arwidcool/Scan-2000/2000 Omron/SCH_Keithley 2000 Omron SCAN V1.0_1-Main_2026-03-22.png

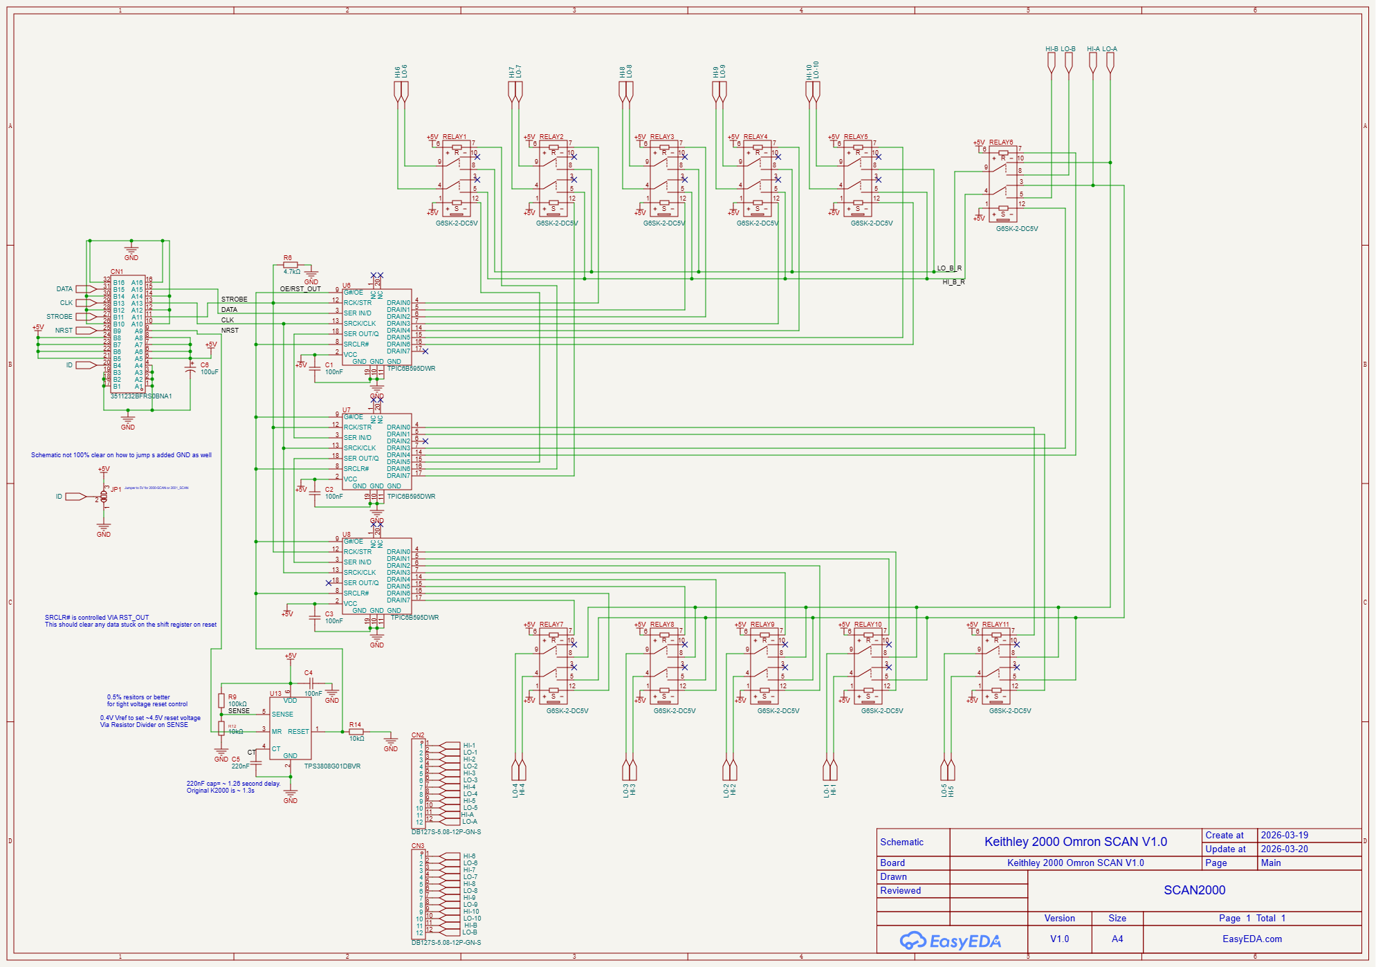
2000 Omron/SCH_Keithley 2000 Omron SCAN V1.0_1-Main_2026-03-22.png
