arwidcool/Scan-2000/2000 Panasonic DB25/SCH_Keithley 2000 SCAN Panasonic DB25 V1.0_1-Main_2026-03-22.png

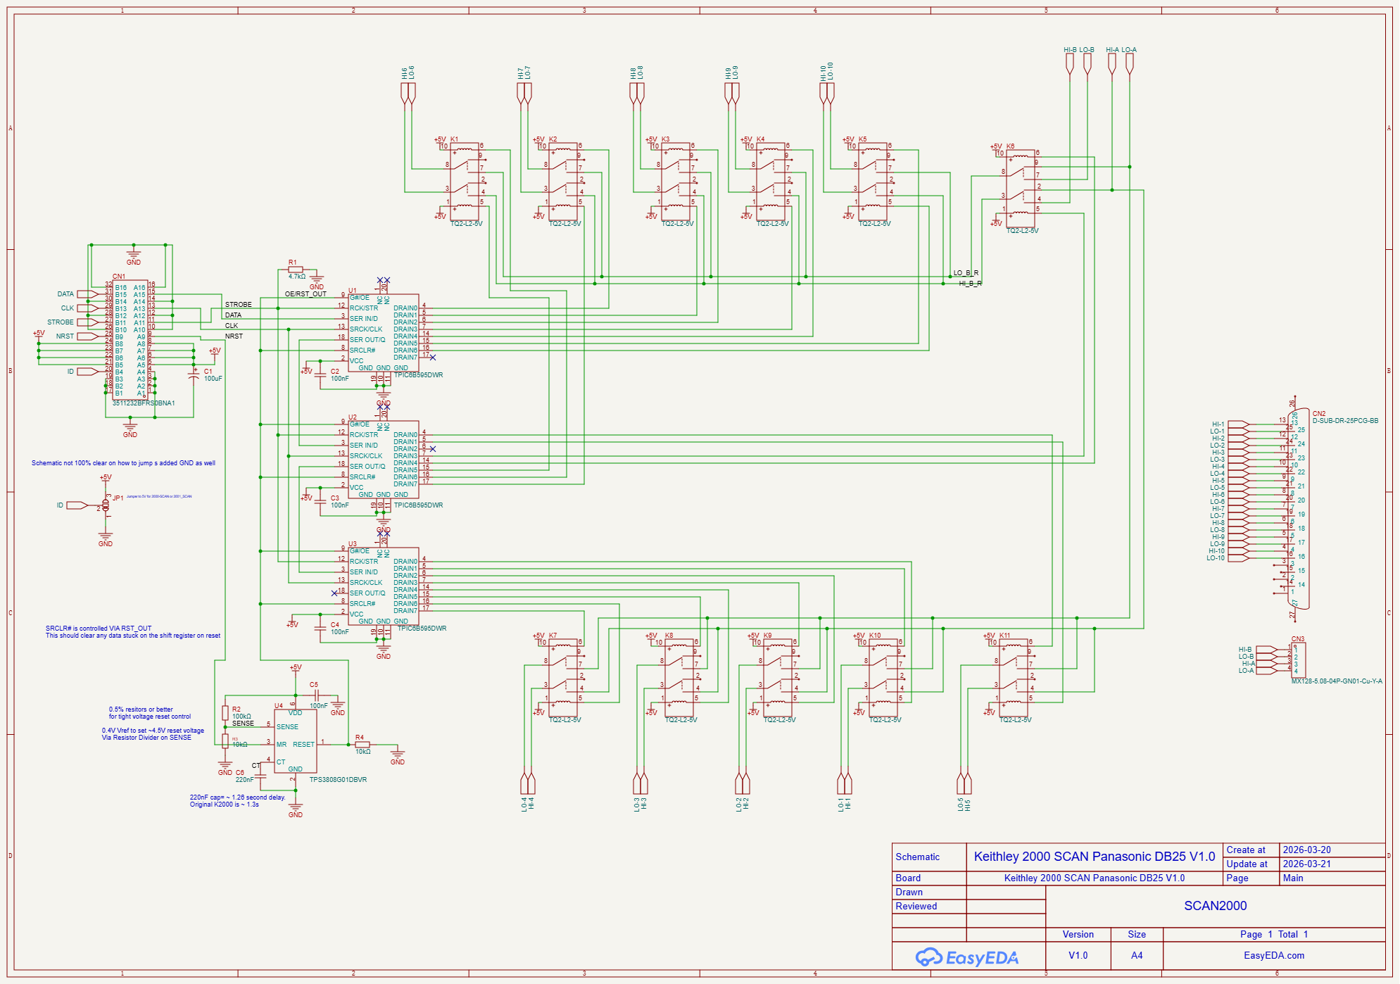
2000 Panasonic DB25/SCH_Keithley 2000 SCAN Panasonic DB25 V1.0_1-Main_2026-03-22.png
