arwidcool/Scan-2000/2001 Omron/SCH_Keithley 2001 Omron SCAN V1.0_1-Main_2026-03-22.png

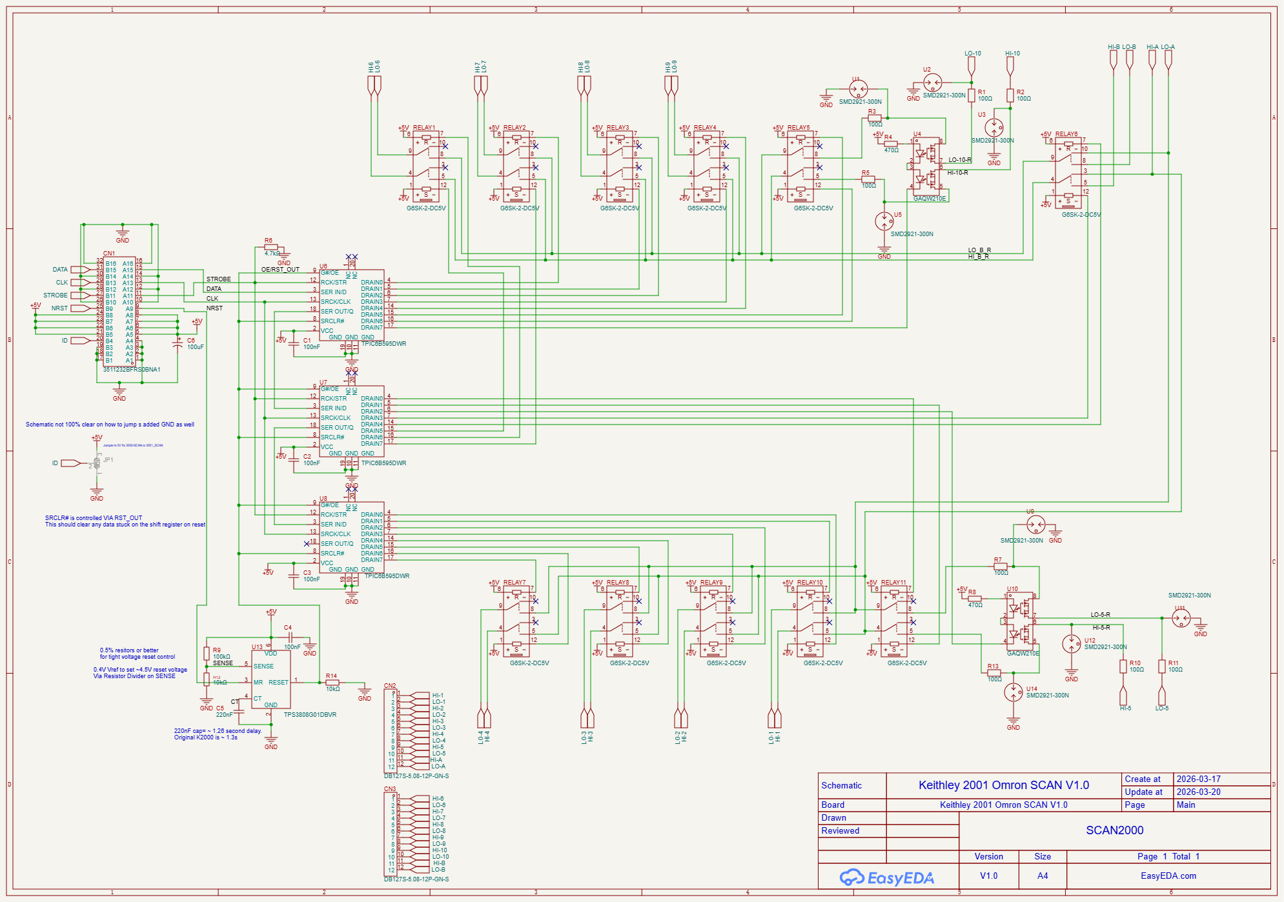
2001 Omron/SCH_Keithley 2001 Omron SCAN V1.0_1-Main_2026-03-22.png
