arwidcool/Scan-2000/2000 Panasonic DB25/BOM_Keithley 2000 SCAN Panasonic DB25 V1.0_Keithley 2000 SCAN Panasonic DB25 V1.0_2026-03-22.xlsx

No. | Quantity | Comment | Designator | Footprint | Value | Manufacturer Part | Manufacturer | Supplier Part | Supplier | LCSC Price | LCSC Stock | Primary Category | Secondary Category | JLCPCB Stock | JLCPCB Price
1 | 1 | 100uF | C1 | CAP-TH_BD8.0-P3.50-D0.6-FD | 100uF | ERJ1HM101F12OT | AISHI(艾华集团) | C106559 | LCSC |  |  | Capacitors | Aluminum Electrolytic Capacitors - Leaded | 12796 | 0.0079
2 | 4 | 100nF | C2,C3,C4,C5 | C0603 | 100nF | CL10B104KB8NNNC | SAMSUNG(三星) | C1591 | LCSC |  |  |  |  | 9229562 | 0.0005
3 | 1 | 220nF | C6 | C0603 | 220nF | CL10B224KA8NNNC | SAMSUNG(三星) | C21120 | LCSC |  |  |  |  | 2661535 | 0.0011
4 | 1 | 3511232BFRS0BNA1 | CN1 | CONN-TH_3511232BFRS0BNA1 |  | 3511232BFRS0BNA1 | JILN(锦凌) | C963692 | LCSC |  |  | Connectors | Board-to-Board and Backplane Connector | 1249 | 0.0912
5 | 1 | D-SUB-DR-25PCG-BB | CN2 | DB25-TH_D-SUB-DR-25PCG-BB |  | D-SUB-DR-25PCG-BB | XUNPU(讯普) | C19077345 | LCSC |  |  | Connectors | D-Sub / VGA Connectors | 695 | 0.1066
6 | 1 | MX128-5.08-04P-GN01-Cu-Y-A | CN3 | CONN-TH_4P-P5.08_MX128-5.08-04P-GN01-CU-Y-A |  | MX128-5.08-04P-GN01-Cu-Y-A | MAX(迈旭) | C5290377 | LCSC |  |  | Connectors | Screw Terminal Blocks | 357 | 0.0406
7 | 1 | Jumper_SolderJumper_3_Bridged12 | JP1 | Jumper:SolderJumper-3_P1.3mm_Bridged12_Pad1.0x1.5mm_NumberLabels | SolderJumper_3_Bridged12 |  |  |  |  | 0.8181
8 | 11 | TQ2-L2-5V | K1,K2,K3,K4,K5,K6,K7,K8,K9,K10,K11 | RELAY-TH_TQ2-L2-XXV |  | TQ2-L2-5V | PANASONIC(松下) | C1525303 | LCSC |  |  | Relays | Magnetic Latching Relays | 228 | 0.2171
9 | 1 | 4.7kΩ | R1 | R0603 | 4.7kΩ | RC0603FR-074K7L | YAGEO(国巨) | C99782 | LCSC |  |  |  |  | 3158032 | 0.0002
10 | 1 | 100kΩ | R2 | R0603 | 100kΩ | AR03DTCX1003 | Viking(光颉) | C319967 | LCSC |  |  | Resistors | Chip Resistor - Surface Mount | 30815 | 0.0019
11 | 1 | 10kΩ | R3 | R0603 | 10kΩ | 0603WAD1002T5E | UNI-ROYAL(厚声) | C167144 | LCSC |  |  | Resistors | Chip Resistor - Surface Mount | 96153 | 0.0009
12 | 1 | 10kΩ | R4 | R0603 | 10kΩ | RC0603FR-0710KL | YAGEO(国巨) | C98220 | LCSC |  |  |  |  | 9420368 | 0.0003
13 | 3 | TPIC6B595DWR | U1,U2,U3 | SOIC-20_L13.0-W7.6-P1.27-LS10.3-BL |  | TPIC6B595DWR | TI(德州仪器) | C7094 | LCSC |  |  | Logic | Shift Registers | 2574 | 0.168
14 | 1 | TPS3808G01DBVR | U4 | SOT-23-6_L2.9-W1.6-P0.95-LS2.8-BR |  | TPS3808G01DBVR | TI(德州仪器) | C19653 | LCSC |  |  | Power Management (PMIC) | Supervisor and Reset ICs | 12068 | 0.053
