arwidcool/Scan-2000/2000 Panasonic/BOM_Keithley 2000 SCAN Panasonic V1.0_Keithley 2000 SCAN Panasonic V1.0_2026-03-22.xlsx

No. | Quantity | Comment | Designator | Footprint | Value | Manufacturer Part | Manufacturer | Supplier Part | Supplier | LCSC Price | LCSC Stock | Primary Category | Secondary Category | JLCPCB Stock | JLCPCB Price
1 | 4 | 100nF | C2,C3,C4,C5 | C0603 | 100nF | CL10B104KB8NNNC | SAMSUNG(三星) | C1591 | LCSC |  |  |  |  | 9229562 | 0.0005
2 | 1 | 220nF | C6 | C0603 | 220nF | CL10B224KA8NNNC | SAMSUNG(三星) | C21120 | LCSC |  |  |  |  | 2661425 | 0.0011
3 | 4 | 22uF | C7,C8,C9,C10 | C0805 | 22uF | CL21A226MAYNNNE | SAMSUNG(三星) | C602037 | LCSC |  |  | Capacitors | Multilayer Ceramic Capacitors MLCC - SMD/SMT | 844649 | 0.005
4 | 1 | 3511232BFRS0BNA1 | CN1 | CONN-TH_3511232BFRS0BNA1 |  | 3511232BFRS0BNA1 | JILN(锦凌) | C963692 | LCSC |  |  | Connectors | Board-to-Board and Backplane Connector | 1249 | 0.0912
5 | 2 | DB127S-5.08-12P-GN-S | CN2,CN3 | CONN-TH_12P-P5.08_DB127S-5.08-12P-GN-S |  | DB127S-5.08-12P-GN-S | DORABO(地博电气) | C18198311 | LCSC |  |  | Connectors | Screw Terminal Blocks | 54 | 0.234
6 | 11 | TQ2-L2-5V | K1,K2,K3,K4,K5,K6,K7,K8,K9,K10,K11 | RELAY-TH_TQ2-L2-XXV |  | TQ2-L2-5V | PANASONIC(松下) | C1525303 | LCSC |  |  | Relays | Magnetic Latching Relays | 228 | 0.2171
7 | 1 | 4.7kΩ | R1 | R0603 | 4.7kΩ | RC0603FR-074K7L | YAGEO(国巨) | C99782 | LCSC |  |  |  |  | 3158032 | 0.0002
8 | 1 | 100kΩ | R2 | R0603 | 100kΩ | AR03DTCX1003 | Viking(光颉) | C319967 | LCSC |  |  | Resistors | Chip Resistor - Surface Mount | 30815 | 0.0019
9 | 1 | 10kΩ | R3 | R0603 | 10kΩ | 0603WAD1002T5E | UNI-ROYAL(厚声) | C167144 | LCSC |  |  | Resistors | Chip Resistor - Surface Mount | 96153 | 0.0009
10 | 1 | 10kΩ | R4 | R0603 | 10kΩ | RC0603FR-0710KL | YAGEO(国巨) | C98220 | LCSC |  |  |  |  | 9420368 | 0.0003
11 | 1 | 390mΩ | R5 | R1206 | 390mΩ | FRL1206FR390TS | FOJAN(富捷) | C2907353 | LCSC |  |  | Resistors | Chip Resistor - Surface Mount | 99036 | 0.0009
12 | 3 | TPIC6B595DWR | U1,U2,U3 | SOIC-20_L13.0-W7.6-P1.27-LS10.3-BL |  | TPIC6B595DWR | TI(德州仪器) | C7094 | LCSC |  |  | Logic | Shift Registers | 2574 | 0.168
13 | 1 | TPS3808G01DBVR | U4 | SOT-23-6_L2.9-W1.6-P0.95-LS2.8-BR |  | TPS3808G01DBVR | TI(德州仪器) | C19653 | LCSC |  |  | Power Management (PMIC) | Supervisor and Reset ICs | 12068 | 0.053
14 | 1 | Solder Jumper New | U5 | Solder Jumper New |  |  |  |  |  | 0.4675 |  | Utilities
