arwidcool/Scan-2000/2001 Omron/BOM_Keithley 2001 Omron SCAN V1.0_Keithley 2001 Omron SCAN V1.0_2026-03-23.xlsx

No. | Quantity | Comment | Designator | Footprint | Value | Manufacturer Part | Manufacturer | Supplier Part | Supplier | LCSC Price | LCSC Stock | Primary Category | Secondary Category | JLCPCB Stock | JLCPCB Price
1 | 4 | 100nF | C1,C2,C3,C4 | C0603 | 100nF | CL10B104KB8NNNC | SAMSUNG(三星) | C1591 | LCSC |  |  |  |  | 9232728 | 0.0005
2 | 1 | 220nF | C5 | C0603 | 220nF | CL10B224KA8NNNC | SAMSUNG(三星) | C21120 | LCSC |  |  |  |  | 2661425 | 0.0011
3 | 1 | 100uF | C6 | CAP-TH_BD8.0-P3.50-D0.6-FD | 100uF | ERJ1HM101F12OT | AISHI(艾华集团) | C106559 | LCSC |  |  | Capacitors | Aluminum Electrolytic Capacitors - Leaded | 12796 | 0.0079
4 | 1 | 3511232BFRS0BNA1 | CN1 | CONN-TH_3511232BFRS0BNA1 |  | 3511232BFRS0BNA1 | JILN(锦凌) | C963692 | LCSC |  |  | Connectors | Board-to-Board and Backplane Connector | 1249 | 0.0912
5 | 2 | DB127S-5.08-12P-GN-S | CN2,CN3 | CONN-TH_12P-P5.08_DB127S-5.08-12P-GN-S |  | DB127S-5.08-12P-GN-S | DORABO(地博电气) | C18198311 | LCSC |  |  | Connectors | Screw Terminal Blocks | 54 | 0.234
6 | 8 | 100Ω | R1,R2,R3,R5,R7,R10,R11,R13 | R1210 | 100Ω | FRC1210J101 TS | FOJAN(富捷) | C2933827 | LCSC |  |  | Resistors | Chip Resistor - Surface Mount | 241621 | 0.0011
7 | 2 | 470Ω | R4,R8 | R0603 | 470Ω | 0603WAF4700T5E | UNI-ROYAL(厚声) | C23179 | LCSC |  |  |  |  | 3909421 | 0.0003
8 | 1 | 4.7kΩ | R6 | R0603 | 4.7kΩ | RC0603FR-074K7L | YAGEO(国巨) | C99782 | LCSC |  |  |  |  | 3158032 | 0.0002
9 | 1 | 100kΩ | R9 | R0603 | 100kΩ | AR03DTCX1003 | Viking(光颉) | C319967 | LCSC |  |  | Resistors | Chip Resistor - Surface Mount | 30815 | 0.0019
10 | 1 | 10kΩ | R12 | R0603 | 10kΩ | 0603WAD1002T5E | UNI-ROYAL(厚声) | C167144 | LCSC |  |  | Resistors | Chip Resistor - Surface Mount | 96153 | 0.0009
11 | 1 | 10kΩ | R14 | R0603 | 10kΩ | RC0603FR-0710KL | YAGEO(国巨) | C98220 | LCSC |  |  |  |  | 9423698 | 0.0003
12 | 11 | G6SK-2-DC5V | RELAY1,RELAY2,RELAY3,RELAY4,RELAY5,RELAY6,RELAY7,RELAY8,RELAY9,RELAY10,RELAY11 | RELAY-TH_G6SK-2-XXX |  | G6SK-2-DC5V | OMRON(欧姆龙) | C2931106 | LCSC |  |  | Relays | Signal Relays | 1191 | 0.1614
13 | 8 | SMD2921-300N | U1,U2,U3,U5,U9,U11,U12,U14 | DIO-DT-SMD_L2.9-W2.1 |  | SMD2921-300N | RUILON | C37923786 | LCSC |  |  | Circuit Protection | Gas Discharge Tube Arresters (GDT) | 1980 | 0.0383
14 | 2 | GAQW210E | U4,U10 | DIP-8_L9.7-W6.6-P2.54-LS7.6-BL |  | GAQW210E | SUPSiC(国晶微半导体) | C7435146 | LCSC |  |  | Optoisolators | Solid State Relays (MOS Output) | 0
15 | 3 | TPIC6B595DWR | U6,U7,U8 | SOIC-20_L13.0-W7.6-P1.27-LS10.3-BL |  | TPIC6B595DWR | TI(德州仪器) | C7094 | LCSC |  |  | Logic | Shift Registers | 2574 | 0.168
16 | 1 | TPS3808G01DBVR | U13 | SOT-23-6_L2.9-W1.6-P0.95-LS2.8-BR |  | TPS3808G01DBVR | TI(德州仪器) | C19653 | LCSC |  |  | Power Management (PMIC) | Supervisor and Reset ICs | 12068 | 0.053
