arwidcool/Scan-2000/2000 Omron/SCH_Keithley 2000 Omron SCAN V1.0_2026-03-22.pdf

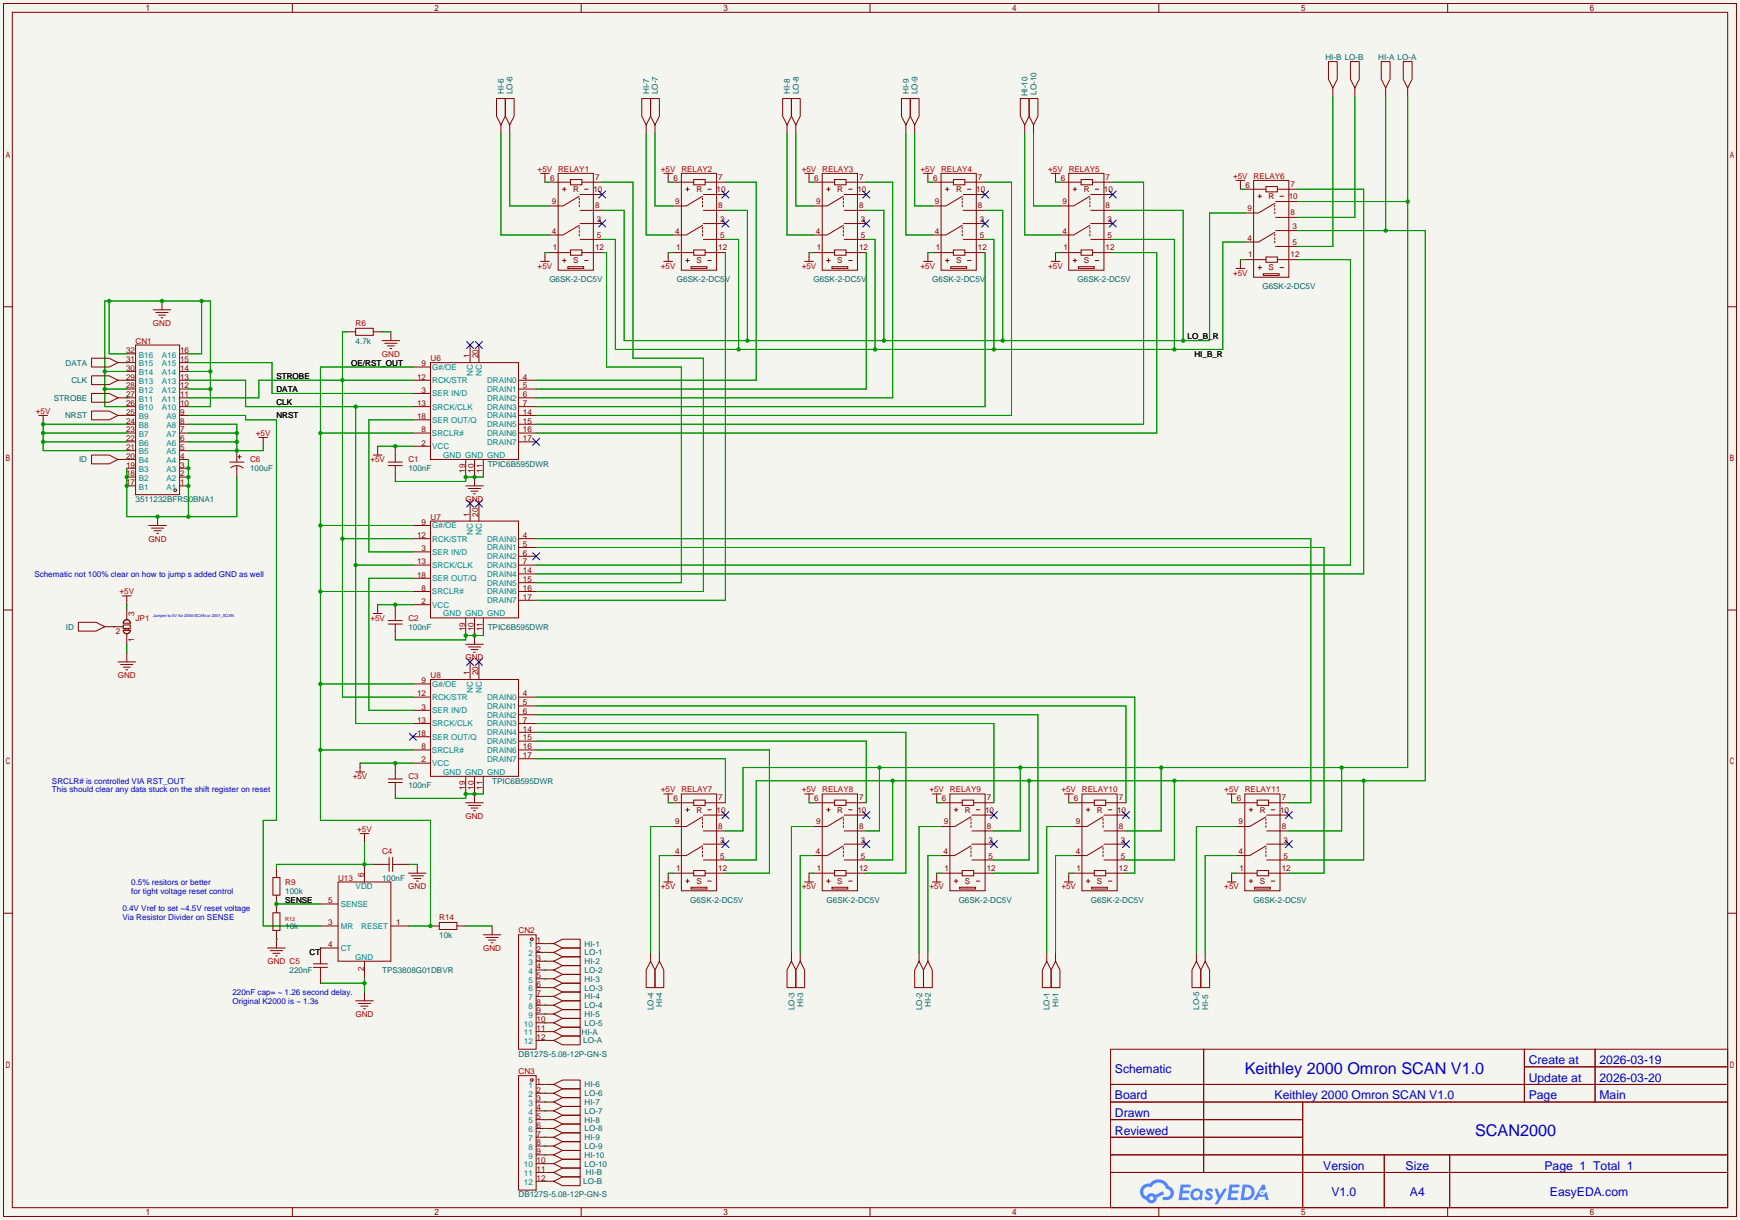
[picture p12: page 1]

SER OUT/Q 18

VCC 2

Schematic not 100% clear on how to jump s added GND as well

Jumper to 5V for 2000-SCAN or 2001_SCAN

SRCLR# is controlled VIA RST_OUT
This should clear any data stuck on the shift register on reset

GND 0.5% resitors or better
for tight voltage reset control
0.4V Vref to set ~4.5V reset voltage
Via Resistor Divider on SENSE

Schematic | Keithley 2000 Omron SCAN V1.0 | Create at | 2026-03-19

Update at | 2026-03-20

Board | Keithley 2000 Omron SCAN V1.0 | Page | Main
Drawn | | SCAN2000
Reviewed

Version | Size | Page 1 Total 1
V1.0 | A4 | EasyEDA.com
