arwidcool/Scan-2000/2000 Panasonic/SCH_Keithley 2000 SCAN Panasonic V1.0_2026-03-22.pdf

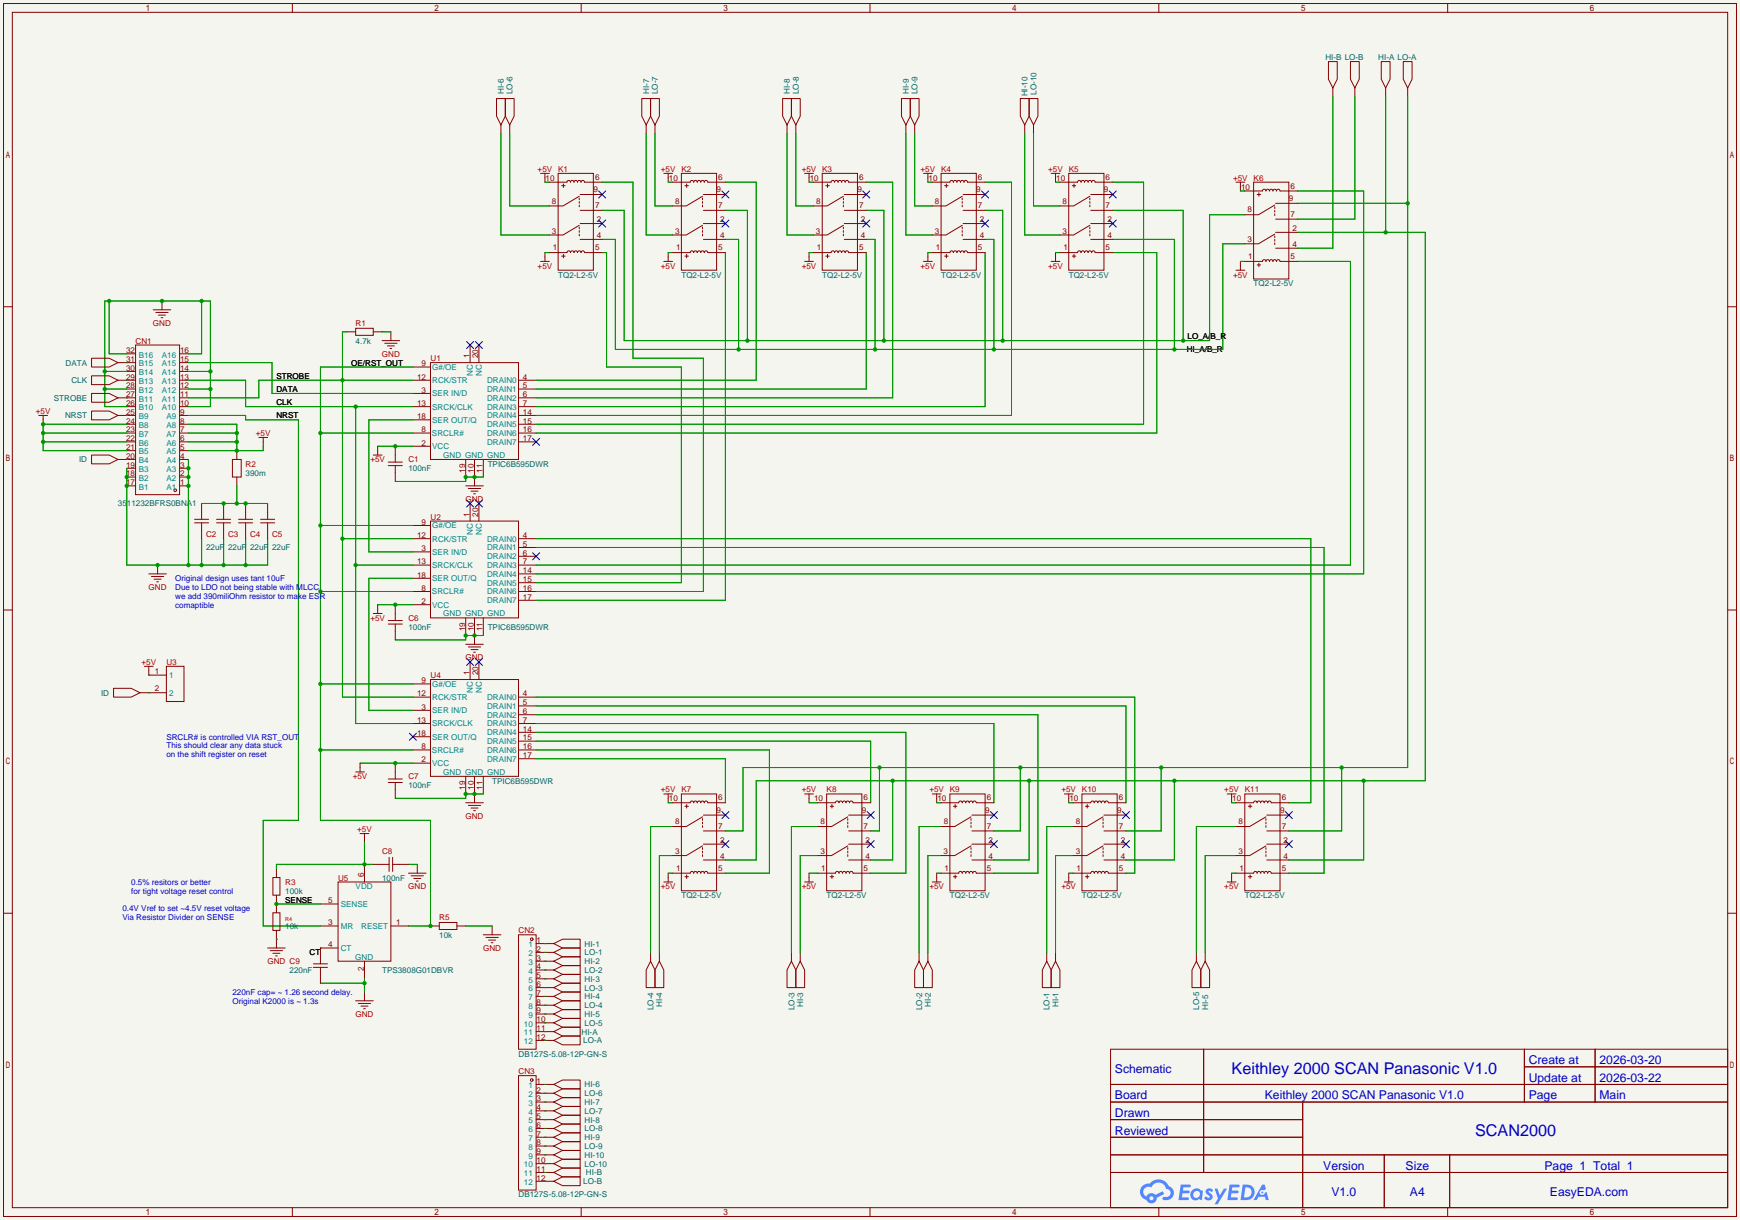
[picture p13: page 1]

SER OUT/Q 18

VCC 2

Original design uses tant 10uF
GND
Due to LDO not being stable with MLCC
we add 390miliOhm resistor to make ESR
comaptible

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

Schematic | Keithley 2000 SCAN Panasonic V1.0 | Create at | 2026-03-20

Update at | 2026-03-22

Board | Keithley 2000 SCAN Panasonic V1.0 | Page | Main
Drawn | | SCAN2000
Reviewed

Version | Size | Page 1 Total 1
V1.0 | A4 | EasyEDA.com
