arwidcool/Scan-2000/(list of files, drawings)

Other design files:
2000 Omron/Keithley 2000 Omron SCAN V1.0.epro
2000 Panasonic DB25/Keithley 2000 SCAN Panasonic DB25 V1.0.epro
2000 Panasonic/Keithley 2000 SCAN Panasonic V1.0.epro
