arwidcool/Scan-2000/(commit log)

2026-03-22 Inital Commit
    [BOM_Keithley 2000 SCAN Panasonic DB25 V1.0_Keithley 2000 SCAN Panasonic DB25 V1.0_2026-03-22.xlsx, BOM_Keithley 2000 SCAN Panasonic V1.0_Keithley 2000 SCAN Panasonic V1.0_2026-03-22.xlsx, BOM_Keithley 2001 Omron SCAN V1.0_Keithley 2001 Omron SCAN V1.0_2026-03-23.xlsx, Keithley 2000 Omron SCAN V1.0.epro, Keithley 2000 SCAN Panasonic DB25 V1.0.epro, Keithley 2000 SCAN Panasonic V1.0.epro, PickAndPl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]
2026-03-22 Simplify README, add PCB images
2026-03-22 Fix specs: Panasonic 125VDC max, Omron earth 350V peak per original Keithley manuals
